JStafford00/garagedoor/InputHardwareDiagram.png

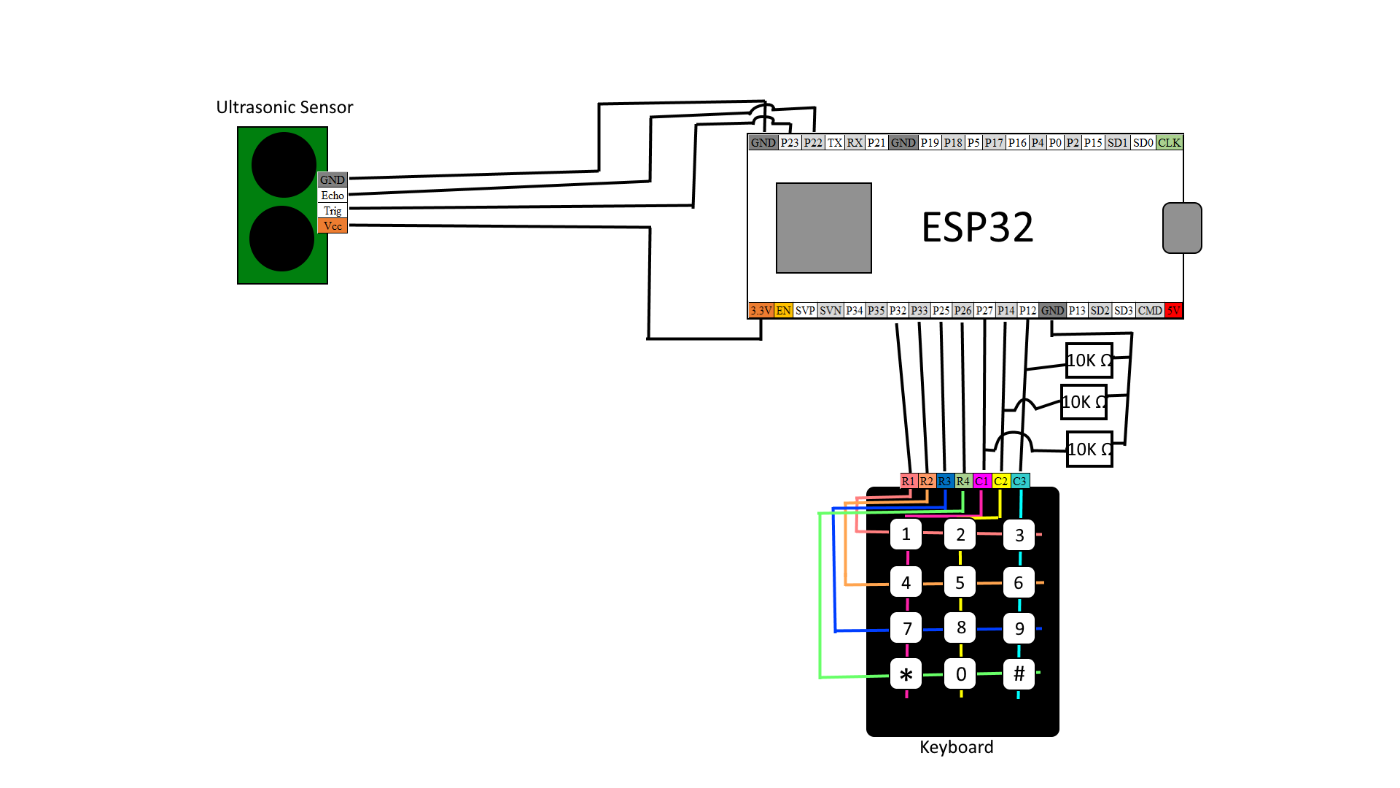
InputHardwareDiagram.png
